sdeghuee/Bus_Pirate/package/hardware/BusPirate-v4_ecard.brd

## EAGLE design package/hardware/BusPirate-v4_ecard.brd (2017-11-21)

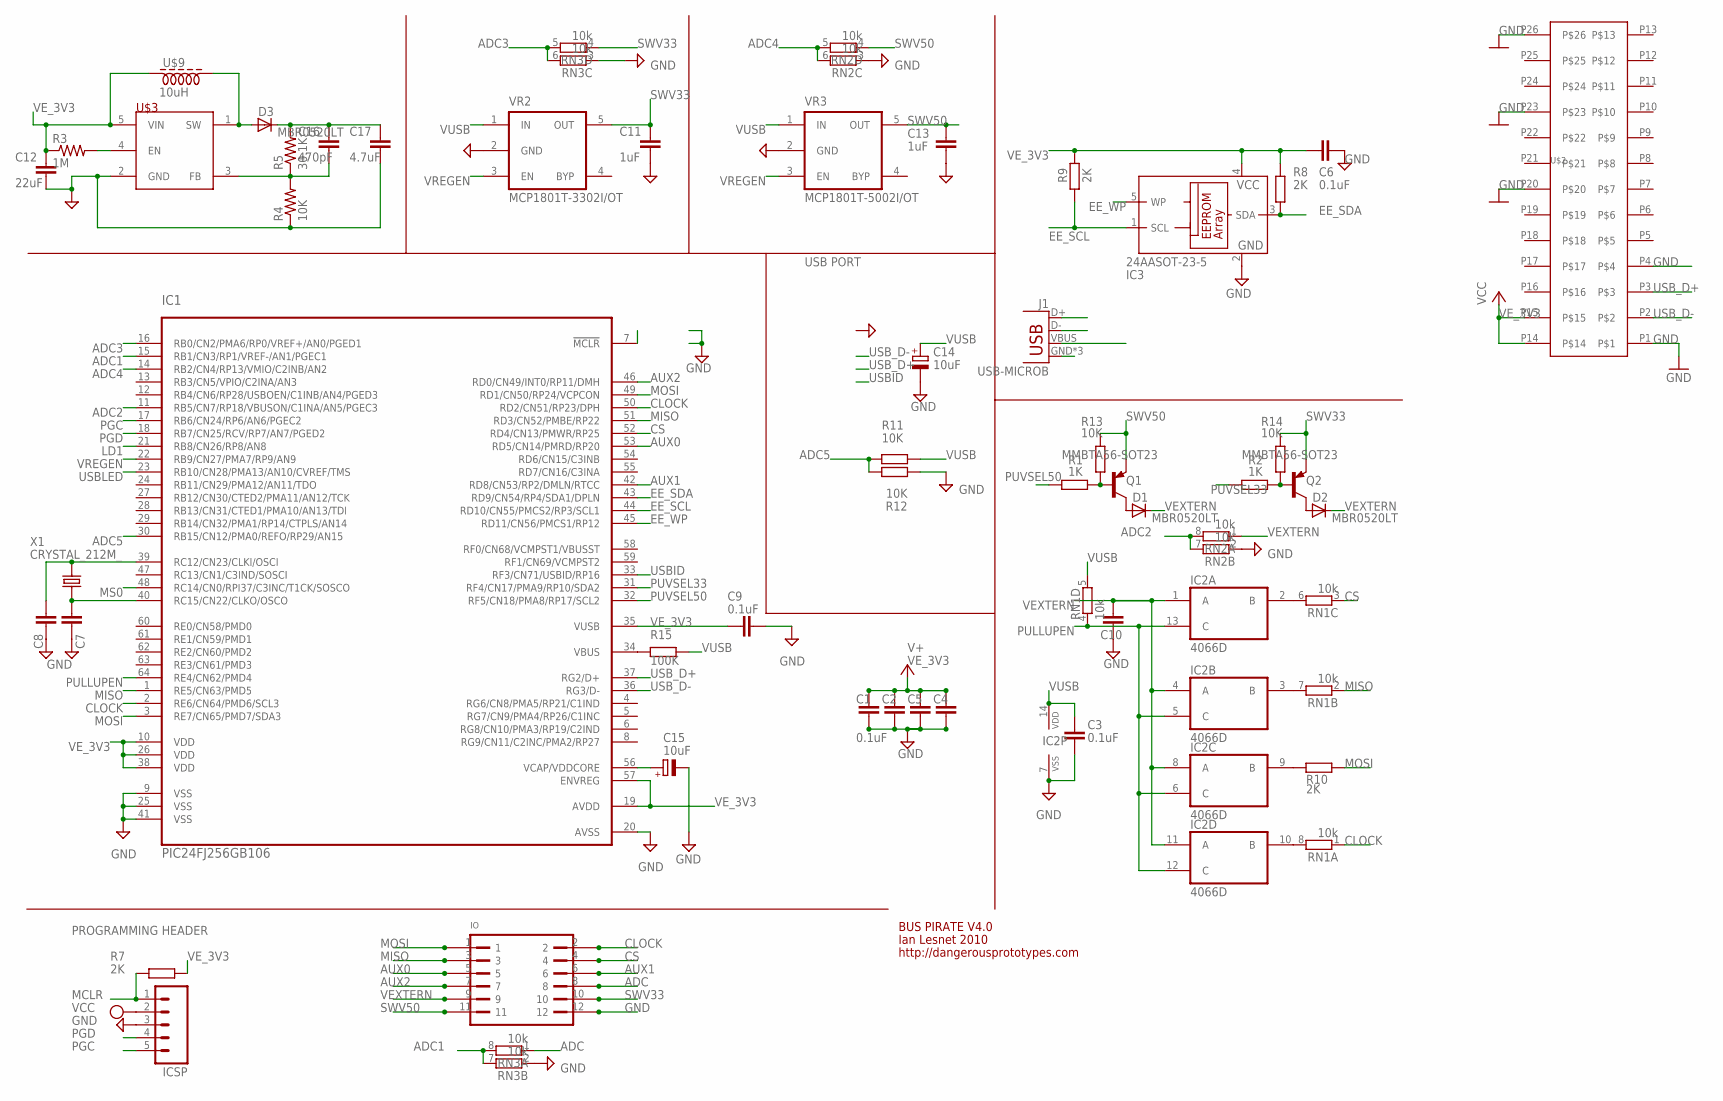
[picture p1: schematic BusPirate-v4_ecard.sch]

Parts:
C1, C2, C3, C4, C5, C6, C9, C10: 0.1uF; C0603
C7, C8: 27pF; C0603
C11, C13: 1uF; C0603
C12: 22uF; C0603
C14, C15: 10uF; SMC_A
C16: 470pF; C0603
C17: 4.7uF; C0603
D1, D2, D3: MBR0520LT; SOD123
IC1: PIC24FJ256GB106; TQFP64-10X10
IC2: 4066D; SO14
IC3: 24AASOT-23-5; SOT-23-5
ICSP: ICSP; 1X05
IO: PINSHRD-PTH-2X06; PINSHRD_PTH_2X06
J1: USB-MICROB
Q1, Q2: MMBTA56-SOT23; SOT23
R1, R2: 1K; R0603
R3: 1M; R0603
R4, R11, R12, R13, R14: 10K; R0603
R5: 30.1K; R0603
R7, R8, R9, R10: 2K; R0603
R15: 100K; R0603
RN1, RN2, RN3: 10k; RN8P-4R-CRA06S
U$2: EXPRESSCARD; EXPRESSCARD_EXPRESSCARD_PACK
U$3: LMR62421; SOT23-DBV
U$9: 10uH; 2520(1008)
VR2: MCP1801T-3302I/OT; SOT-23-5
VR3: MCP1801T-5002I/OT; SOT-23-5
X1: CRYSTAL_212M_; 4X6

Connections:
ADC: IO.8, RN3.1
ADC1: IC1.15 (RB1/CN3/RP1/VREF-/AN1/PGEC1), RN3.7 (2), RN3.8 (2)
ADC2: IC1.11 (RB5/CN7/RP18/VBUSON/C1INA/AN5/PGEC3), RN2.7 (2), RN2.8 (2)
ADC3: IC1.16 (RB0/CN2/PMA6/RP0/VREF+/AN0/PGED1), RN3.5 (2), RN3.6 (2)
ADC4: IC1.14 (RB2/CN4/RP13/VMIO/C2INB/AN2), RN2.5 (2), RN2.6 (2)
ADC5: IC1.30 (RB15/CN12/PMA0/REFO/RP29/AN15), R11.2, R12.2
AUX0: IC1.53 (RD5/CN14/PMRD/RP20), IO.5
AUX1: IC1.42 (RD8/CN53/RP2/DMLN/RTCC), IO.6
AUX2: IC1.46 (RD0/CN49/INT0/RP11/DMH), IO.7
CLOCK: IC1.2 (RE6/CN64/PMD6/SCL3), IC1.50 (RD2/CN51/RP23/DPH), IO.2, RN1.1
CS: IC1.52 (RD4/CN13/PMWR/RP25), IO.4, RN1.3 (1)
EE_SCL: IC1.44 (RD10/CN55/PMCS2/RP3/SCL1), IC3.1 (SCL), R9.1
EE_SDA: IC1.43 (RD9/CN54/RP4/SDA1/DPLN), IC3.3 (SDA), R8.1
EE_WP: IC1.45 (RD11/CN56/PMCS1/RP12), IC3.5 (WP)
GND: C1.2, C2.2, C3.2, C4.2, C5.2, C6.2, C7.2, C8.2, C9.2, C10.2, C11.2, C12.2, C13.2, C14.-, C15.-, C17.2, IC1.9 (VSS), IC1.20 (AVSS), IC1.25 (VSS), IC1.41 (VSS), IC2.7 (VSS), IC3.2 (GND), ICSP.3, IO.12, J1.GND, J1.MT1 (GND), J1.MT2 (GND), R4.1, R12.1, RN2.2 (1), RN2.3 (1), RN3.2 (1), RN3.3 (1), U$2.P1, U$2.P4, U$2.P20, U$2.P23, U$2.P26, U$3.2 (GND), VR2.2 (GND), VR3.2 (GND)
LD1: IC1.21 (RB8/CN26/RP8/AN8)
MCLR: IC1.7 (!MCLR), ICSP.1, R7.1
MISO: IC1.1 (RE5/CN63/PMD5), IC1.51 (RD3/CN52/PMBE/RP22), IO.3, RN1.2 (1)
MOSI: IC1.3 (RE7/CN65/PMD7/SDA3), IC1.49 (RD1/CN50/RP24/VCPCON), IO.1, R10.1
MS0: IC1.48 (RC14/CN0/RPI37/C3INC/T1CK/SOSCO)
unnamed: IC2.9 (B), R10.2
unnamed: IC2.10 (B), RN1.8 (2)
unnamed: D1.A, Q1.3 (C)
unnamed: IC2.2 (B), RN1.6 (2)
unnamed: IC2.3 (B), RN1.7 (2)
unnamed: D3.A, U$3.1 (SW), U$9.2
unnamed: R3.2, U$3.4 (EN)
unnamed: Q2.1 (B), R2.1, R14.2
unnamed: C7.1, IC1.40 (RC15/CN22/CLKO/OSCO), X1.2 (X2)
unnamed: C15.+, IC1.56 (VCAP/VDDCORE)
unnamed: IC1.34 (VBUS), R15.2
unnamed: C8.1, IC1.39 (RC12/CN23/CLKI/OSCI), X1.1 (X1)
unnamed: D2.A, Q2.3 (C)
unnamed: C16.2, R4.2, R5.1, U$3.3 (FB)
unnamed: Q1.1 (B), R1.1, R13.2
PGC: IC1.17 (RB6/CN24/RP6/AN6/PGEC2), ICSP.5
PGD: IC1.18 (RB7/CN25/RCV/RP7/AN7/PGED2), ICSP.4
PULLUPEN: IC1.64 (RE4/CN62/PMD4), IC2.5 (C), IC2.6 (C), IC2.12 (C), IC2.13 (C), RN1.4 (1)
PUVSEL33: IC1.31 (RF4/CN17/PMA9/RP10/SDA2), R2.2
PUVSEL50: IC1.32 (RF5/CN18/PMA8/RP17/SCL2), R1.2
SWV33: C11.1, IO.10, Q2.2 (E), R14.1, RN3.4 (1), VR2.5 (OUT)
SWV50: C13.1, IO.11, Q1.2 (E), R13.1, RN2.4 (1), VR3.5 (OUT)
USBID: IC1.33 (RF3/CN71/USBID/RP16)
USBLED: IC1.23 (RB10/CN28/PMA13/AN10/CVREF/TMS)
USB_D+: IC1.37 (RG2/D+), J1.D+, U$2.P3
USB_D-: IC1.36 (RG3/D-), J1.D-, U$2.P2
VEXTERN: C10.1, D1.C, D2.C, IC2.1 (A), IC2.4 (A), IC2.8 (A), IC2.11 (A), IO.9, RN2.1
VE_3V3: C1.1, C2.1, C4.1, C5.1, C6.1, C9.1, C12.1, IC1.10 (VDD), IC1.19 (AVDD), IC1.26 (VDD), IC1.35 (VUSB), IC1.38 (VDD), IC1.57 (ENVREG), IC3.4 (VCC), ICSP.2, R3.1, R7.2, R8.2, R9.2, U$2.P14, U$2.P15, U$3.5 (VIN), U$9.1
VREGEN: IC1.22 (RB9/CN27/PMA7/RP9/AN9), VR2.3 (EN), VR3.3 (EN)
VUSB: C3.1, C14.+, C16.1, C17.1, D3.C, IC2.14 (VDD), J1.VBUS, R5.2, R11.1, R15.1, RN1.5 (2), VR2.1 (IN), VR3.1 (IN)

Notes on the sheet:
PROGRAMMING HEADER
BUS PIRATE V4.0
Ian Lesnet 2010
http://dangerousprototypes.com
USB PORT

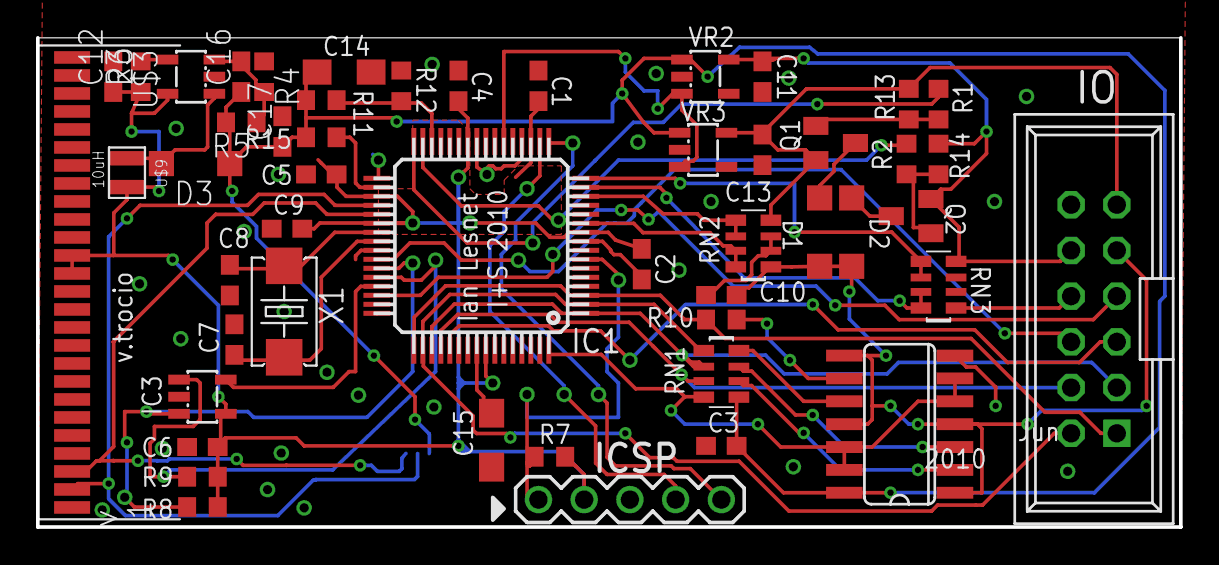
[picture p2: board BusPirate-v4_ecard.brd from above]

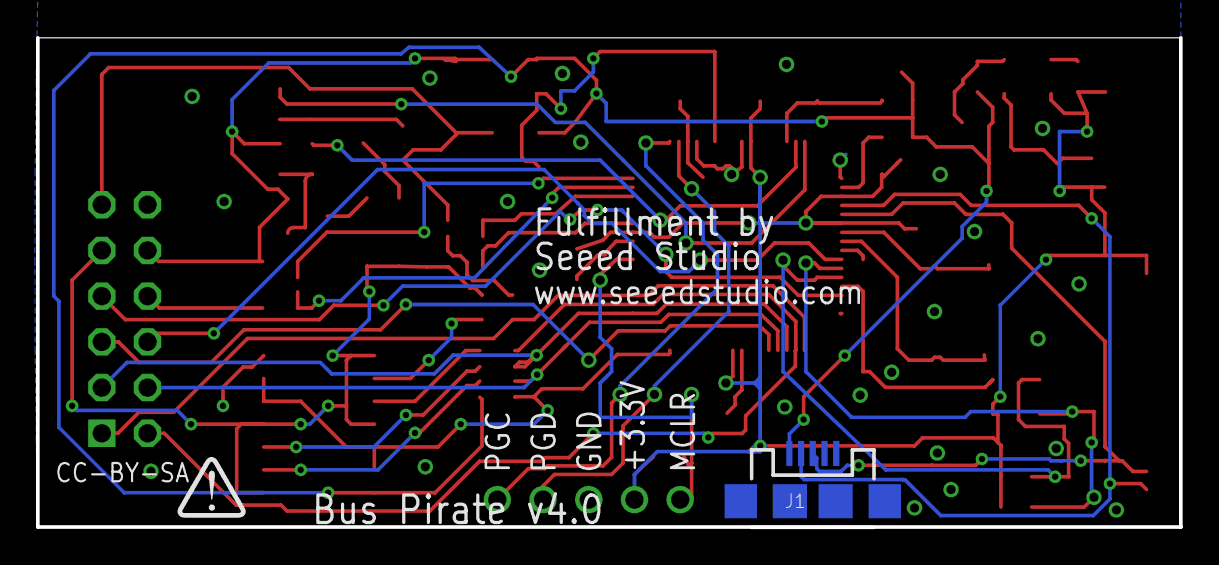
[picture p3: board BusPirate-v4_ecard.brd from below]

Board: 2 copper layers, 63.5 x 27.2 mm, 52 parts (2 on the bottom side), 46 nets.

Other parts of the board:
U$1: DP-LOGO
