sdeghuee/Bus_Pirate/(notices)

Notices in the files:
package/hardware/BusPirate-v4_ecard.brd:
CC-BY-SA
parts and their libraries:
SparkFun-Connectors: Licensing: Creative Commons ShareAlike 4.0 International - https://creativecommons.org/licenses/by-sa/4.0
